Alan-JH/lemp11-nas/README.md

# lemp11-nas
Lemur Pro 11 to Low Power NAS Conversion
