Alan-JH/lemp11-nas/SATA_board/LM5175 Buck-Boost Quickstart Tool -- r9.xlsm

Sheet: Design Converter
LM5175 DC/DC Controller Design Tool
 |  |  |  |  |  |  |  |  |  |  | http://www.ti.com/product/lm5175
About |  | xx (http://www.ti.com/pol) |  |  | = Input Box |  |  |  |  |  | TERMS OF USE
Step 1: Operating Specifications
 |  |  | Input Voltage - Min, VIN(min) | 5 | V
 |  |  | Input Voltage - Nom, VIN(nom) | 19 | V
 |  |  | Input Voltage - Max, VIN(max) | 24 | V
 |  |  | Output Voltage, VOUT | 12 | V
 |  |  | Full Load Output Current, IOUT(max) | 6 | A
 |  |  | Switching Frequency | 224 | kHz
 |  |  | Frequency Set Resistor, RT | 115 | kΩ
Step 2: Filter Inductor
 |  |  | Recommended Filter Inductance | 4.2 | µH
 |  |  | Inductance, LF | 4.7 | µH
 |  |  | Inductor DCR | 6 | mΩ
 |  |  | Pk-to-Pk Ripple Current at VIN(min), DIL1 | 2.8 | Apk-pk
 |  |  | Pk-to-Pk Ripple Current at VIN(nom), DIL2 | 4.2 | Apk-pk
 |  |  | Pk-to-Pk Ripple Current at VIN(max), DIL3 | 5.7 | Apk-pk
 |  |  | DIL as a % at VIN(min) | 18.89568601 | %
 |  |  | DIL as a % at VIN(nom) | 70.30112057 | %
 |  |  | DIL as a % at VIN(max) | 95.45877849 | %
Step 3: OCP, Sense Resistors, Slope Comp
 |  |  | Required IOCP(MIN) Setpoint at VIN(nom) | 8 | A
 |  |  | Recommended Sense Resistance | 7.5 | mΩ
 |  |  | Sense Resistance, RS | 8 | mΩ
 |  |  | Peak Inductor Current, ILPK | 20.0 | A
 |  |  | Power Loss in Rs at Full Load (Min VIN) | 1.08 | W
 |  |  | Recommended SLOPE Capacitance | 150 | pF
 |  |  | SLOPE Capacitance, CSLOPE | 150 | pF
 |  |  | VIN(min) | 7.5 | A
 |  | IOUT(typ) at OCP Inception: | VIN(nom) | 12.1 | A
 |  |  | VIN(max) | 12.9 | A
 |  |  | Required Const Current Loop Setpoint | N/A | A
 |  |  | Output Leg Shunt Resistance, RCS(out) | 0 | mΩ
Step 4: Output Capacitor
 |  |  | Output Voltage Ripple Spec | 120 | mVpk-pk
 |  |  | Minimum Output Capacitance | 133.2 | µF
 |  |  | Output Capacitance, COUT | 272 | µF
 |  |  | Maximum Permitted ESR | 10.2 | mΩ
 |  |  | Output Capacitor ESR | 7 | mΩ
 |  |  | Resulting Output Voltage Ripple (max) | 100.771141 | mVpk-pk
 |  |  | Output Capacitor RMS Current (max) | 7.1 | A (rms)
 |  |  |  |  |  |  |  |  | VIN(nom) | 19V
Step 5: Input Capacitor
 |  |  | Input Voltage Ripple Spec | 100 | mVpk-pk
 |  |  | Minimum Input Capacitance | 67.0 | µF
 |  |  | Input Capacitance, CIN | 100 | µF
 |  |  | Maximum Permitted ESR | 3.7 | mΩ
 |  |  | Input Capacitor ESR | 2 | mΩ
 |  |  | Resulting Input Voltage Ripple (max) | 84.69181242 | mVpk-pk
 |  |  | Input Capacitor RMS Current (max) | 3.0 | A (rms)
Step 6: Soft-start, Dither, UVLO
 |  |  | Soft-Start Time, tSS | 15 | ms
 |  |  | Soft-Start Capacitance, CSS | 100 | nF
 |  |  | Modulating Frequency | 5 | kHz
 |  |  | DITH Capacitance, Cd | 8.2 | nF
 |  |  | Required Input Voltage UVLO On | 5.5 | V
 |  |  | Input Voltage UVLO Off | 4.84 | V
 |  |  | Upper UVLO Resistor, RUV1 | 200 | kΩ
 |  |  | Lower UVLO Resistor, RUV2 | 52.3 | kΩ
Step 7: Compensation Design
 |  |  | Load Pole Frequency | 781.5500886 | Hz
 |  |  | COUT ESR Zero Frequency | 83.58978113 | kHz
 |  |  | Boost RHP Zero Frequency | 9.052552037 | kHz
 |  |  | Desired Crossover Frequency | 10 | kHz
 |  |  | Error Amp Pole Frequency | 2.039626021 | Hz
 |  |  | Upper Feedback Resistor, RFB1 | 100 | kΩ
 |  |  | Lower Feedback Resistor, RFB2 | 7.15 | kΩ
Compensation Components
 | Calculated / | Std Values | Selected |  | Actual P/Z Frequencies
RC | 8.1 | 8.06 | 8.06 | kΩ | 2.039626021 | Hz (FPEA) | Min COMP Voltage | 1.07V
CC1 | 3.9 | 3.9 | 3.9 | nF | 5.1 | kHz (FZCOMP) | Max COMP Voltage | 2.58V
CC2 | 210.548727 | 220 | 220 | pF | 80.5096637 | kHz (FPCOMP)
Efficiency / Power Loss Analyzer
Step 8: Efficiency
 |  |  | Buck-Leg Power MOSFETs (Q1, Q2) | CSD18563Q5A
 |  |  |  | Hi-side | Low-side
 |  |  | On-State Resistance, RDS(on) | 3.4 | 5.3 | mΩ
 |  |  | Total Gate Charge, QG | 27 | 16 | nC
 |  |  | Gate-Drain Charge, QGD | 4.3 | 2.4 | nC
 |  |  | Gate-Source Charge, QGS | 4.5 | 3.2 | nC
 |  |  | Gate Resistance, RG | 1.2 | 1.4 | Ω
 |  |  | Transconductance, gFS | 100 | 71 | S
 |  |  | Gate-Source Threshold Voltage, VTH | 1.8 | 1.9 | V
 |  |  | Body Diode Forward Voltage, VBD | 0.8 | 0.8 | V
 |  |  | Body Diode Rev Recovery Charge, QRR |  | 39 | nC
 |  |  | Thermal Resistance, θJA | 50 | 50 | °C/W
 |  |  | Boost-Leg Power MOSFETs (Q3, Q4) | CSD16321Q5
 |  |  |  | Hi-side | Low-side
 |  |  | On-State Resistance, RDS(on) | 1.9 | 1.9 | mΩ
 |  |  | Total Gate Charge, QG | 22 | 22 | nC
 |  |  | Gate-Drain Charge, QGD | 2.5 | 2.5 | nC
 |  |  | Gate-Source Charge, QGS | 4 | 4 | nC
 |  |  | Gate Resistance, RG | 1.5 | 1.5 | Ω
 |  |  | Transconductance, gFS | 150 | 150 | S
 |  |  | Gate-Source Threshold Voltage, VTH | 2 | 2 | V
 |  |  | Body Diode Forward Voltage, VBD | 0.8 | 0.8 | V
 |  |  | Body Diode Rev Recovery Charge, QRR | 33 |  | nC
 |  |  | Thermal Resistance, θJA | 50 | 50 | °C/W
External Schottky Diode (if applicable) |  |  |  | Buck Leg | Boost Leg
 |  |  | Schottky Fwd Voltage, VFWDsch | 0 | 0 | V
 |  |  | Schottky Rev Recovery Charge, QRRsch | 0 | 0 | nC

Sheet: BOM & Schematic
 | ** Tie MODE to VCC (or voltage > 2.4V) for CCM, GND for DCM **
VIN = 5 V to 24 V, VOUT = 12 V, IOUT = 6 A, Fsw = 224 kHz, Current Limit = 8 A
High Efficiency Synchronous Buck-Boost Regulator BOM
Count | Ref Des | Value | Description |  | Size | Part Number | MFR
2 | CBOOT1, CBOOT2 | 0.1µF | Capacitor, Ceramic,0.1-µF, 50V, X7R, 20% |  | 0603 | Std | Std
1 | CC1 | 3.9nF | Capacitor, Ceramic,3.9-nF, 16V, X7R, 10% |  | 0603 | Std | Std
1 | CC2 | 220pF | Capacitor, Ceramic,220-pF, 50V, NP0, 5% |  | 0603 | Std | Std
1 | CSLOPE | 150pF | Capacitor, Ceramic,150-pF, 50V, NP0, 5% |  | 0603 | Std | Std
1 | CCS | 100pF | Capacitor, Ceramic,100-pF, 16V, X7R, 10% |  | 0603 | Std | Std
1 | CDITH | 8.2nF | Capacitor, Ceramic,8.2-nF, 16V, X7R, 10% |  | 0603 | Std | Std
10 | CIN | 10µF | Capacitor, Ceramic,10-µF, 50V, X7R, 20% |  | 1210 | Std | Std
13 | COUT | 22µF | Capacitor, Ceramic,22-µF, 25V, X5R, 20% |  | 1210 | Std | Std
1 | CSS | 100nF | Capacitor, Ceramic,100-nF, 16V, X7R, 10% |  | 0603 | Std | Std
1 | CVCC | 1µF | Capacitor, Ceramic,1-µF, 25V, X7R, 20% |  | 0603 | Std | Std
1 | CVIN | 0.1µF | Capacitor, Ceramic,0.1-µF, 100V, X7R, 20% |  | 0603 | Std | Std
3 | DBOOT1, DBOOT2, DVIN | See description | Schottky Diode, 200mA |  | - | - | Various
1 | LF | 4.7µH | Inductor, 4.7µH, 6mΩ, >22A |  | - | - | Various
2 | Q1, Q2 | See description | MOSFET, N-CH, 60V,3.4mΩ |  | Std | CSD18563Q5A | -
2 | Q3, Q4 | See description | MOSFET, N-CH, 60V,1.9mΩ |  | Std | CSD16321Q5 | -
1 | RC1 | 8.06k | Resistor, Chip,8.06-kΩ, 1/16W, 1% |  | 0603 | Std | Std
1 | RS | 8m | Resistor, Chip,8-mΩ, 2W, 1% |  | 2512 | Std | Std
1 | RCS(out) | 0m | Resistor, Chip,0-mΩ, 2W, 1% |  | 2512 | Std | Std
1 | RT | 115k | Resistor, Chip,115-kΩ, 1/16W, 1% |  | 0603 | Std | Std
1 | RFB1 | 100k | Resistor, Chip,100-kΩ, 1/16W, 1% |  | 0603 | Std | Std
1 | RFB2 | 7.15k | Resistor, Chip,7.15-kΩ, 1/16W, 1% |  | 0603 | Std | Std
1 | RPGOOD | 20k | Resistor, Chip,20-kΩ, 1/16W, 1% |  | 0603 | Std | Std
2 | RCS, RCSG | 100 | Resistor, Chip,100-Ω, 1/16W, 1% |  | 0603 | Std | Std
1 | RUV1 | 200k | Resistor, Chip,200-kΩ, 1/16W, 1% |  | 0603 | Std | Std
1 | RUV2 | 52.3k | Resistor, Chip,52.3-kΩ, 1/16W, 1% |  | 0603 | Std | Std
1 | RVIN | 2.2 | Resistor, Chip,2.2-Ω, 1/16W, 1% |  | 0603 | Std | Std
1 | U1 | LM5175 | IC, LM5175, Buck-Boost PWM Controller, 3.5V–42V Input |  | QFN-28 | LM5175RHF | TI
 |  |  |  |  | TSSOP-28 | LM5175PWP
NOTES:
** For information on TI NexFETTM MOSFETs, see ** |  |  | http://www.ti.com/nexfet | **
** Inductor saturation current should be higher than the peak inductor current at the OCP setpoint for all input voltages and operating temperatures **
** Effective input and output capacitances should be appropriately derated for applied voltage and temperature, particularly with ceramics **

Sheet: EVMs
LM5175 Quickstart Design Tool
 | LM5175EVM-HD PCB Layout | LM5175EVM-HP PCB Layout | LM5175EVM PCB Layout
