Alan-JH/lemp11-nas/case/lemp11-mainboard-test-left.STL

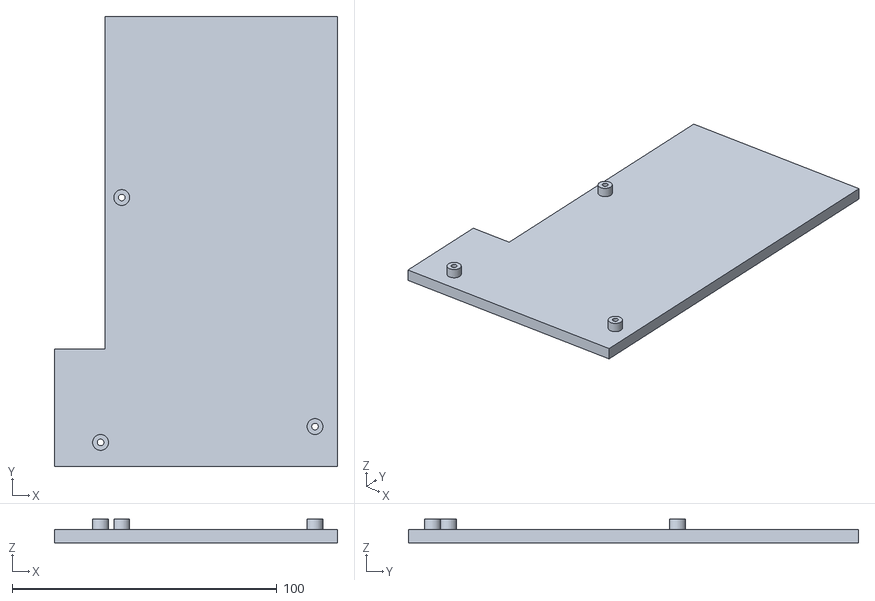
[picture p1: CAD file, 2026-09-23]
case/lemp11-mainboard-test-left.STL
106.9 x 170.0 x 9.00
