Alan-JH/lemp11-nas/case/lemp11-mainboard-test.SLDPRT

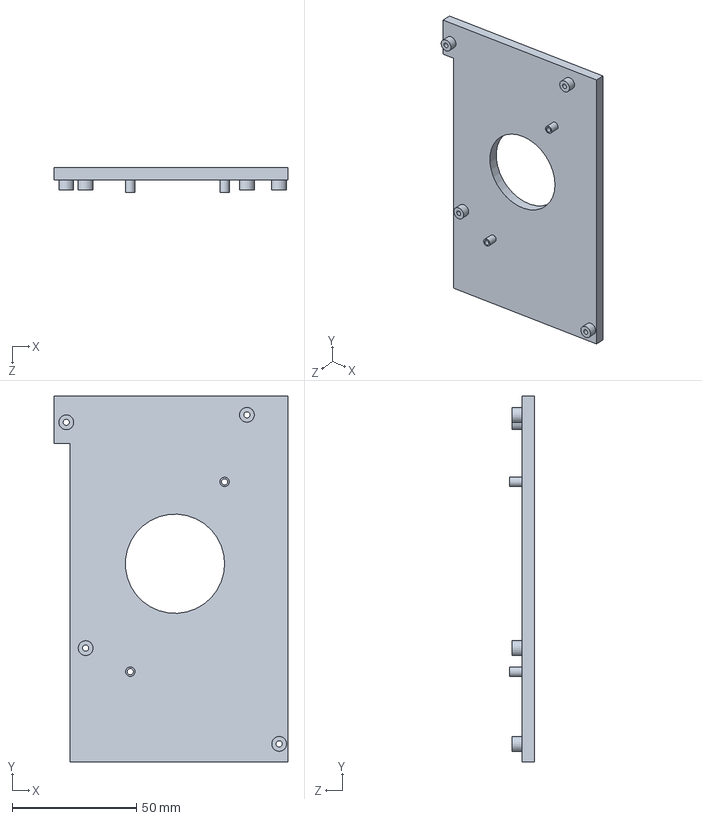
[picture p2: CAD file, 2026-09-23]
case/lemp11-mainboard-test.SLDPRT
94.2 x 147.5 x 10.0 mm
