Alan-JH/lemp11-nas/case/topcase.STEP

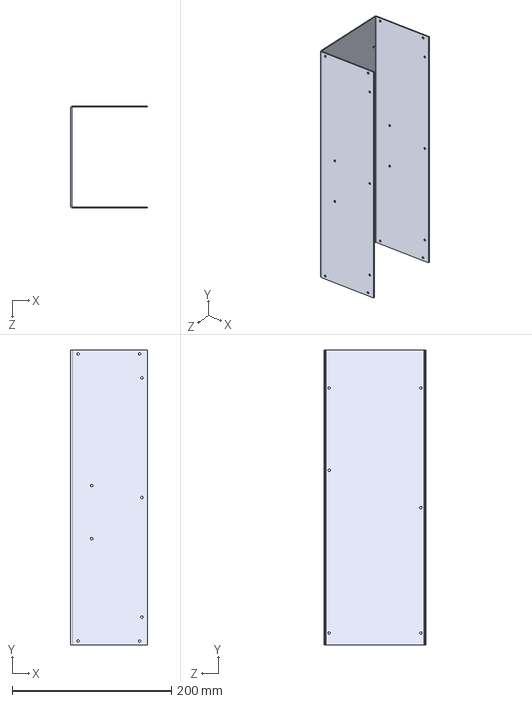
[picture p3: CAD file, 2026-10-31]
case/topcase.STEP
96.6 x 370.0 x 128.2 mm
