Alan-JH/lemp11-nas/SATA_board/CFP15_SOT1289_NEX.step

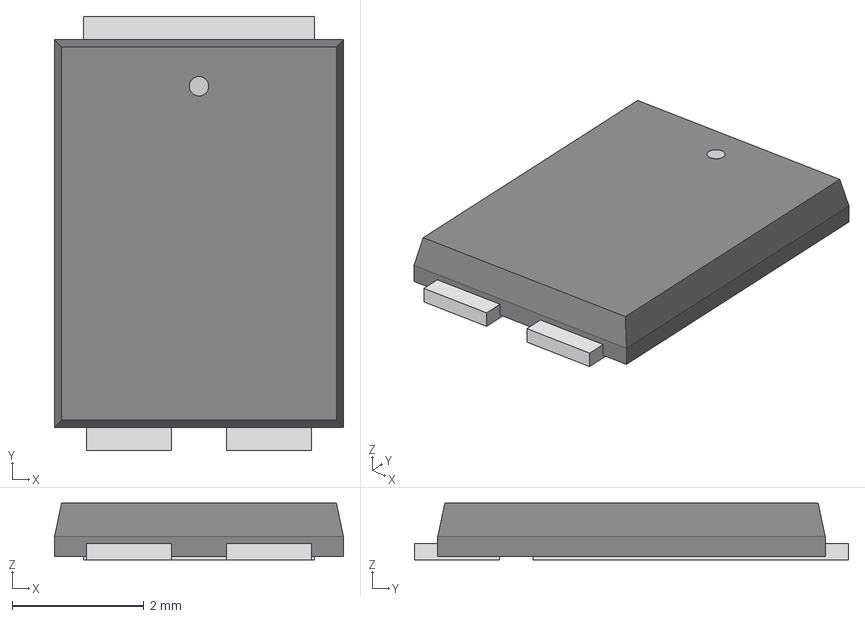
[picture p4: CAD file, 2026-10-28]
SATA_board/CFP15_SOT1289_NEX.step
4.39 x 6.60 x 0.866 mm
