Alan-JH/lemp11-nas/case/lemp11-mountingplate.STEP

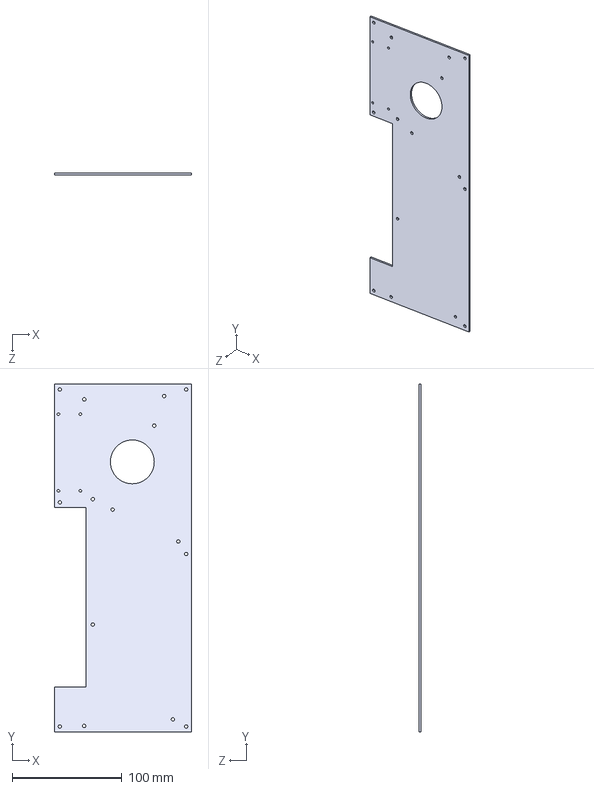
[picture p5: CAD file, 2026-10-31]
case/lemp11-mountingplate.STEP
125.0 x 317.3 x 2.00 mm
