Alan-JH/lemp11-nas/case/Boardmount.STEP

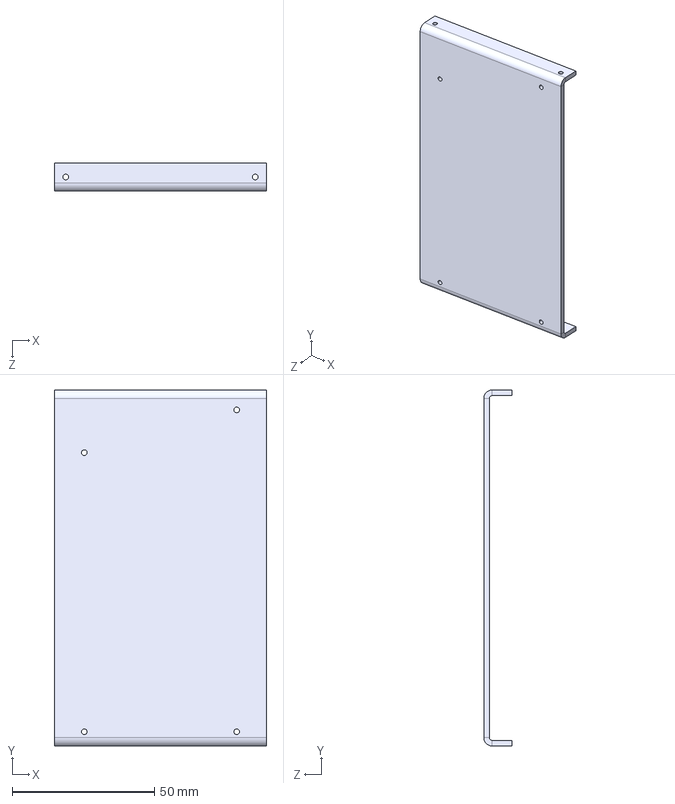
[picture p6: CAD file, 2026-10-31]
case/Boardmount.STEP
74.5 x 125.0 x 10.0 mm
