Alan-JH/lemp11-nas/case/bottomcase.STEP

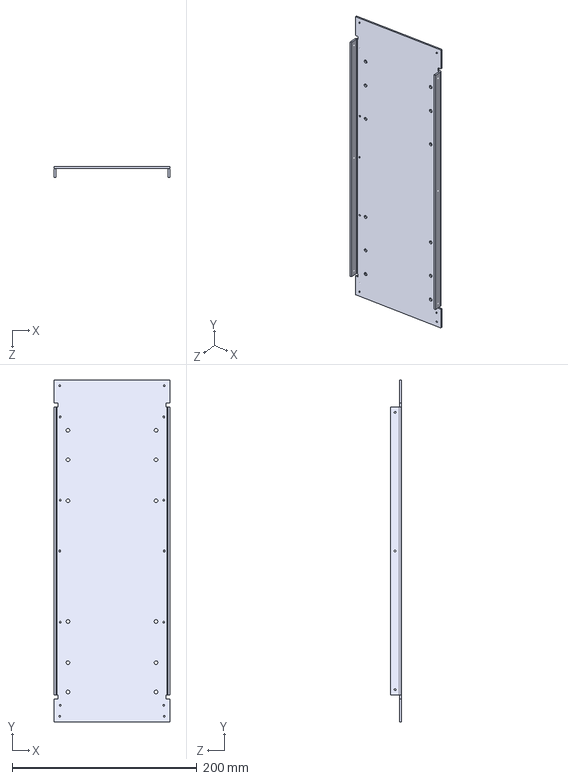
[picture p7: CAD file, 2026-10-31]
case/bottomcase.STEP
125.0 x 370.0 x 12.0 mm
