Alan-JH/lemp11-nas/case/heatsink.SLDPRT

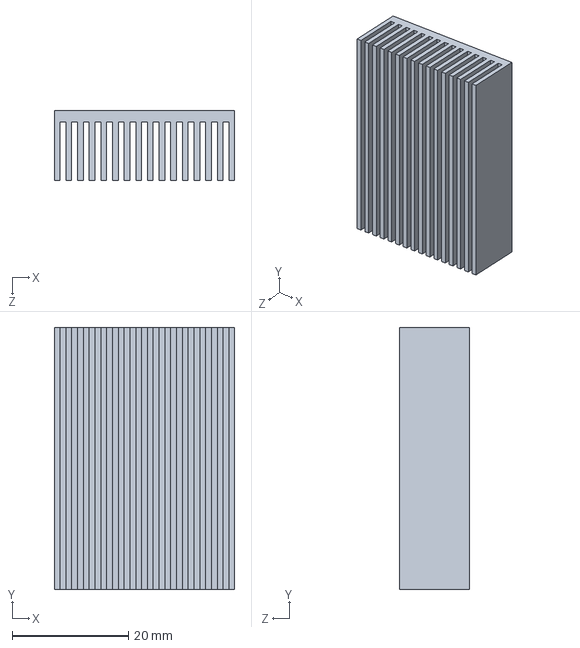
[picture p8: CAD file, 2026-10-28]
case/heatsink.SLDPRT
31.0 x 45.0 x 12.0 mm
