Alan-JH/lemp11-nas/case/SATA_board.step

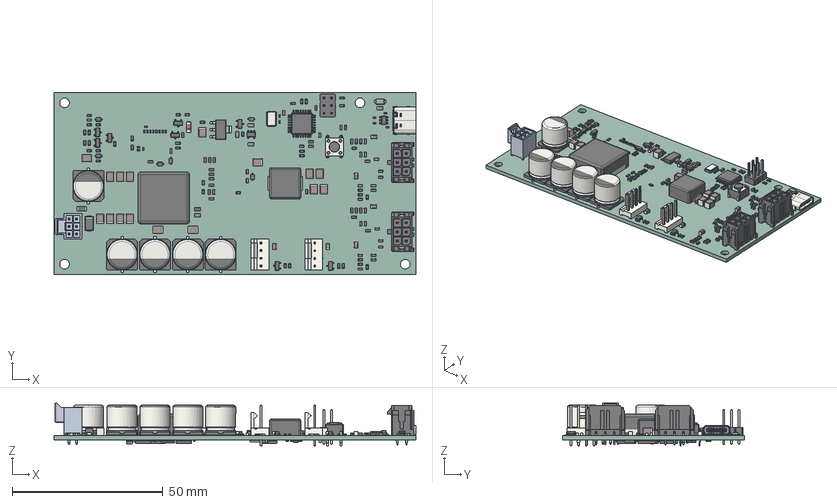
[picture p9: CAD file, 2026-10-28]
case/SATA_board.step
120.1 x 60.5 x 14.2 mm
C_0603_1608Metric x 43
C_1210_3225Metric x 16
C_0402_1005Metric x 8
R_0402_1005Metric x 14
D_SMA
R_0603_1608Metric x 58
D_SOD-323F x 9
FanPinHeader_1x04_P2.54mm_Vertical x 2
CP_Elec_10x10 x 5
SOT-23 x 8
C_0805_2012Metric x 12
SOT-23-6
PinHeader_2x03_P2.54mm_Vertical
SW_PUSH_6mm
L_Vishay_IHLP-4040
Fuse_1206_3216Metric
SOT-23-5
USB_C_Receptacle_GCT_USB4105-xx-A_16P_TopMnt_Horizontal
D_MiniMELF
Crystal_SMD_Abracon_ABM3B-4Pin_5.0x3.2mm
D_SMF
L_Vishay_IHLP-6767
LQFP-32_7x7mm_P0.8mm
R_0805_2012Metric x 2
SOT-223
TDSON-8-1 x 6
R_2512_6332Metric x 2
CFP15_SOT1289_NEX x 2
SATA_board_PCB
