Alan-JH/lemp11-nas/case/ssdplate.SLDPRT

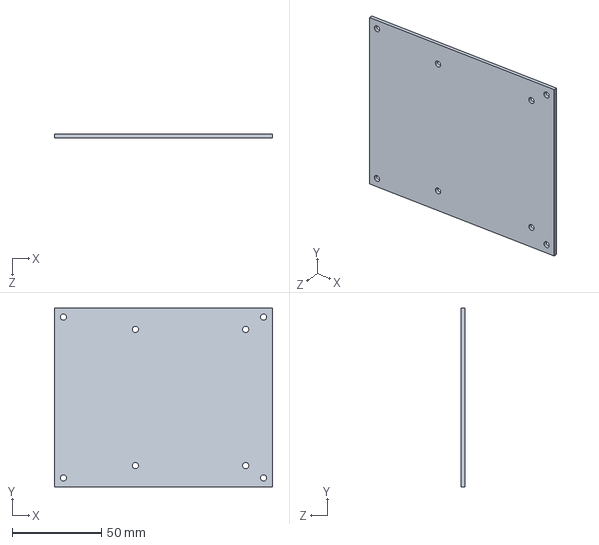
[picture p10: CAD file, 2026-10-28]
case/ssdplate.SLDPRT
122.0 x 100.0 x 2.00 mm
