Alan-JH/lemp11-nas/case/iocover.SLDPRT

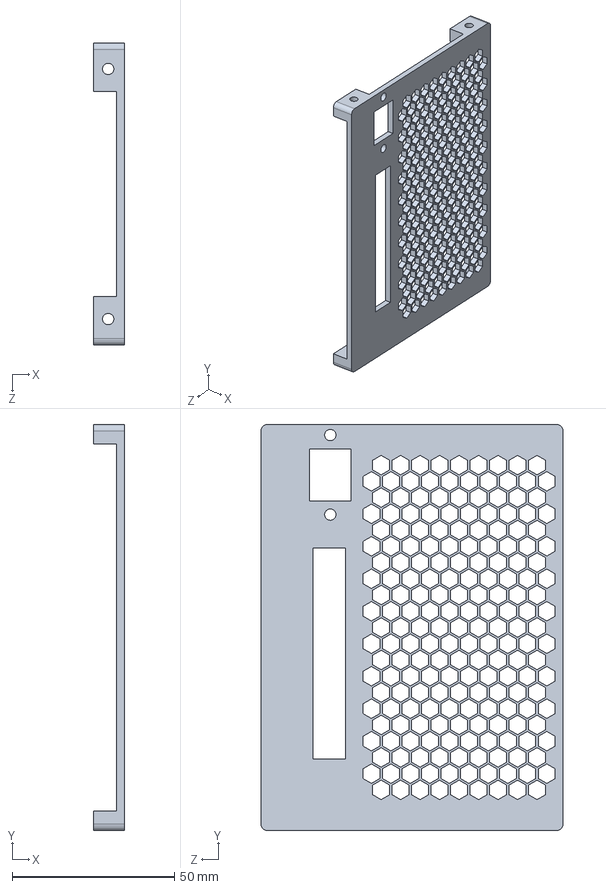
[picture p11: CAD file, 2026-10-28]
case/iocover.SLDPRT
9.50 x 125.0 x 93.0 mm
