Alan-JH/lemp11-nas/case/SSD_SATA_2.5.step

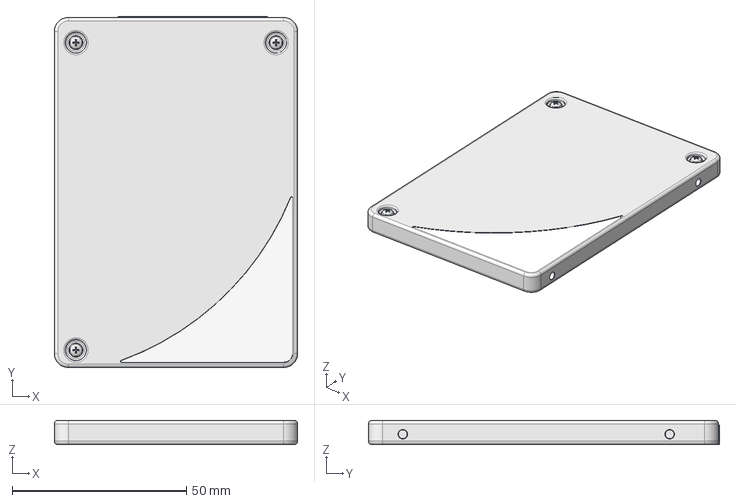
[picture p12: CAD file, 2026-10-27]
case/SSD_SATA_2.5.step
69.8 x 100.8 x 7.00 mm
