Alan-JH/lemp11-nas/case/feet.SLDPRT

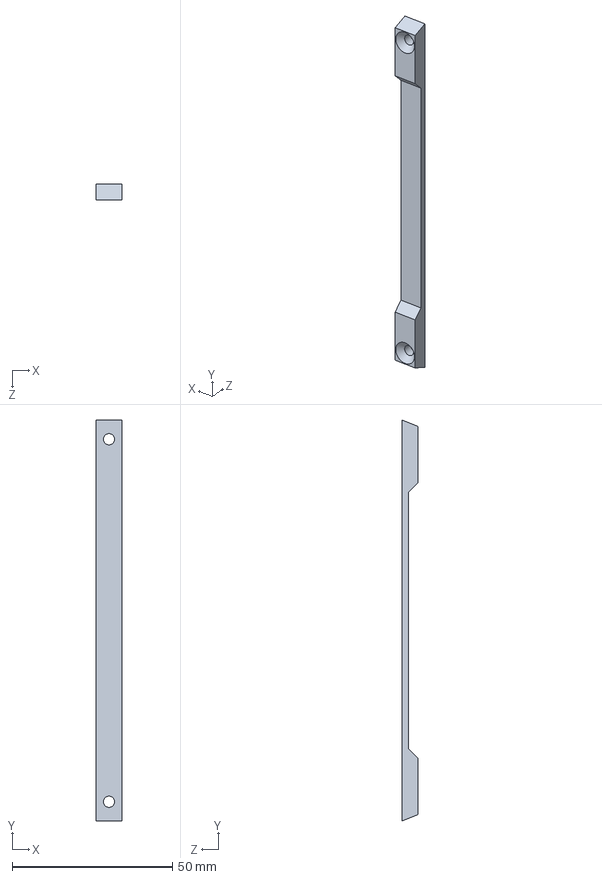
[picture p13: CAD file, 2026-10-27]
case/feet.SLDPRT
8.00 x 125.0 x 5.00 mm
