Alan-JH/lemp11-nas/case/F9.STEP

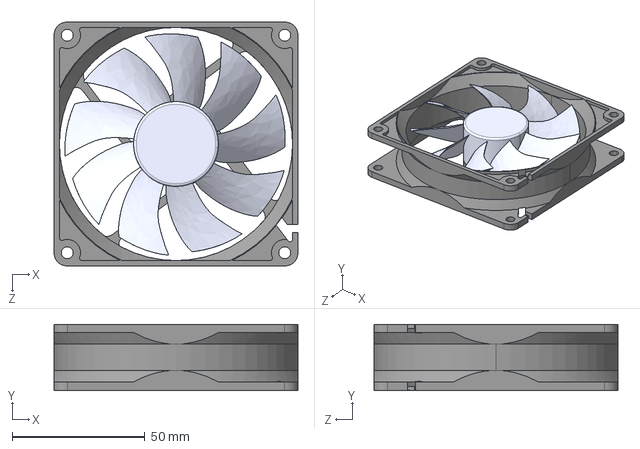
[picture p14: CAD file, 2026-10-27]
case/F9.STEP
92.0 x 25.0 x 92.0 mm
F9 body
F9 fan
