Alan-JH/lemp11-nas/case/fanmount.SLDPRT

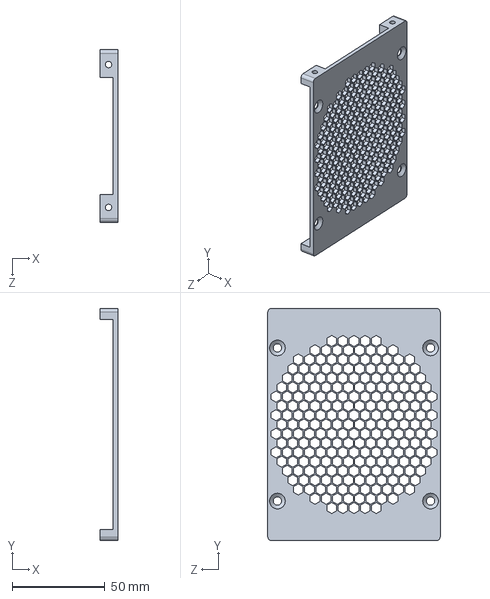
[picture p15: CAD file, 2026-10-27]
case/fanmount.SLDPRT
9.50 x 125.0 x 93.0 mm
