Alan-JH/lemp11-nas/case/lemp11-battery-lowerplate.SLDPRT

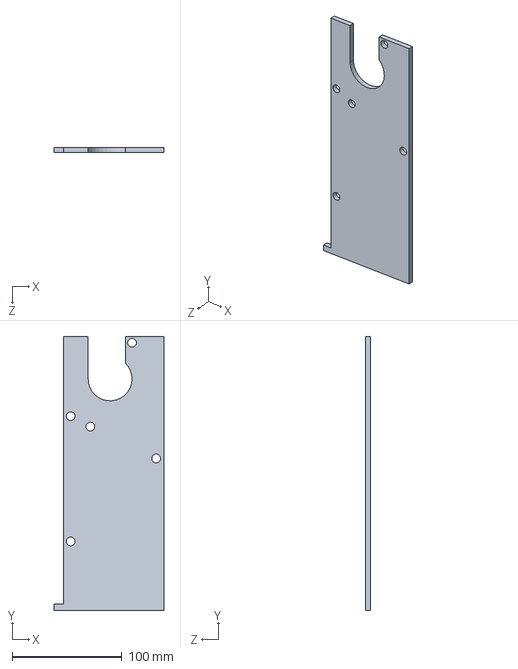
[picture p16: CAD file, 2026-10-16]
case/lemp11-battery-lowerplate.SLDPRT
100.0 x 250.0 x 5.00 mm
