Alan-JH/lemp11-nas/case/Assembly.SLDASM

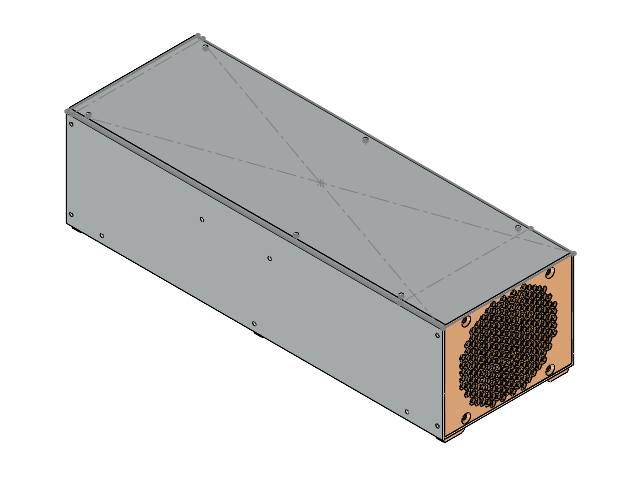
[picture p17: CAD file, 2026-10-31]
case/Assembly.SLDASM
bottomcase
topcase
lemp11-mountingplate
feet x 3
fanmount
F9 body.STEP
F9 fan.STEP
EL90126--STD--HDD SATA 3.5 x 2
iocover
ssdplate x 2
93655A229_Male-Female Threaded Hex Standoff x 8
Body.step x 2
Body002.step x 2
ANSI B18.6.7M - M2x0,4 x 2,5.step x 6
SOLID.step
COMPOUND.step
C_0603_1608Metric.step x 43
C_1210_3225Metric.step x 16
C_0402_1005Metric.step x 8
R_0402_1005Metric.step x 14
D_SMA.step
R_0603_1608Metric.step x 58
D_SOD-323F.step x 9
FanPinHeader_1x04_P2.54mm_Vertical.step x 2
CP_Elec_10x10.step x 5
SOT-23.step x 8
C_0805_2012Metric.step x 12
SOT-23-6.step
PinHeader_2x03_P2.54mm_Vertical.step
SW_PUSH_6mm.step
L_Vishay_IHLP-4040.step
Fuse_1206_3216Metric.step
SOT-23-5.step
USB_C_Receptacle_GCT_USB4105-xx-A_16P_TopMnt_Horizontal.step
D_MiniMELF.step
Crystal_SMD_Abracon_ABM3B-4Pin_5.0x3.2mm.step
430450612.step x 2
D_SMF.step
L_Vishay_IHLP-6767.step
LQFP-32_7x7mm_P0.8mm.step
R_0805_2012Metric.step x 2
SOT-223.step
TDSON-8-1.step x 6
R_2512_6332Metric.step x 2
CFP15_SOT1289_NEX.step x 2
SATA_board_PCB.step
92080A415_Zinc-Plated Brass Female Threaded Hex Standoff x 6
Boardmount
