Alan-JH/lemp11-nas/(list of files, cad)

Other CAD files:
case/lemp11-mainboard-test-right.STL
SATA_board/1053101206.stp
SATA_board/430450612.stp
case/92080A415_Zinc-Plated Brass Female Threaded Hex Standoff.SLDPRT
case/93655A100_Male-Female Threaded Hex Standoff.SLDPRT
case/93655A229_Male-Female Threaded Hex Standoff.SLDPRT
case/94868A012_Female Threaded Hex Standoff.SLDPRT
case/Boardmount.SLDPRT
case/EL90126--STD--HDD SATA 3.5.SLDPRT
case/EL90126--STD--HDD SATA 3.5.STEP
case/F9.SLDASM
case/SATA_board.SLDASM
case/SSD_SATA_2.5.SLDASM
case/bottomcase.SLDPRT
case/fanmount.STL
case/lemp11-mountingplate.DXF
case/lemp11-mountingplate.SLDPRT
case/topcase.SLDPRT
