Alan-JH/lemp11-nas/SATA_board/SATA_board.kicad_pcb

## KiCad design SATA_board/SATA_board.kicad_pcb (2026-10-28)

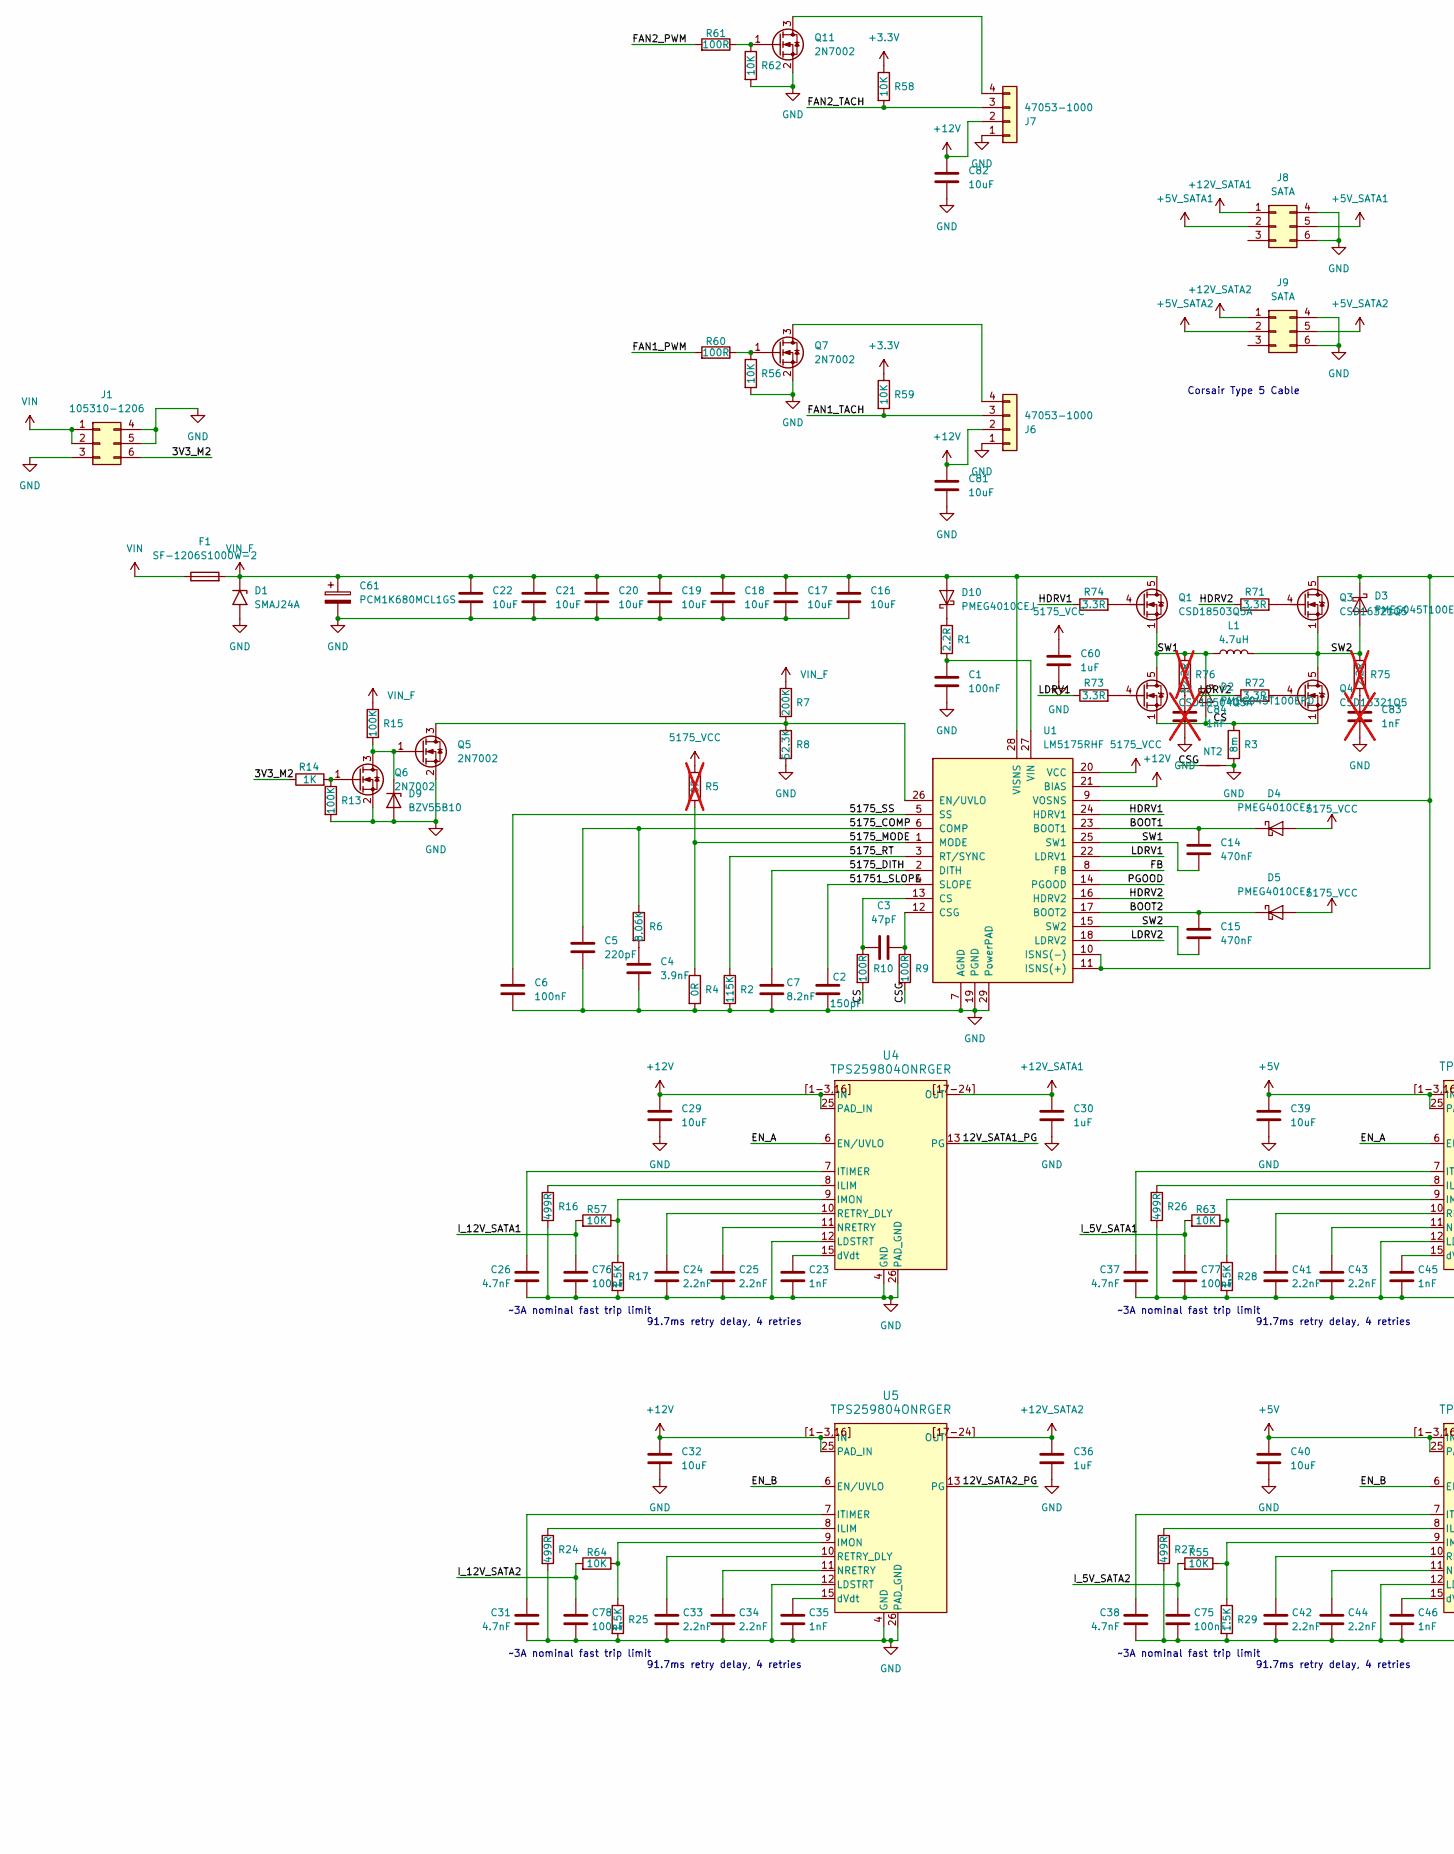
[picture p18: schematic SATA_board.kicad_sch, part in row 1, column 1]

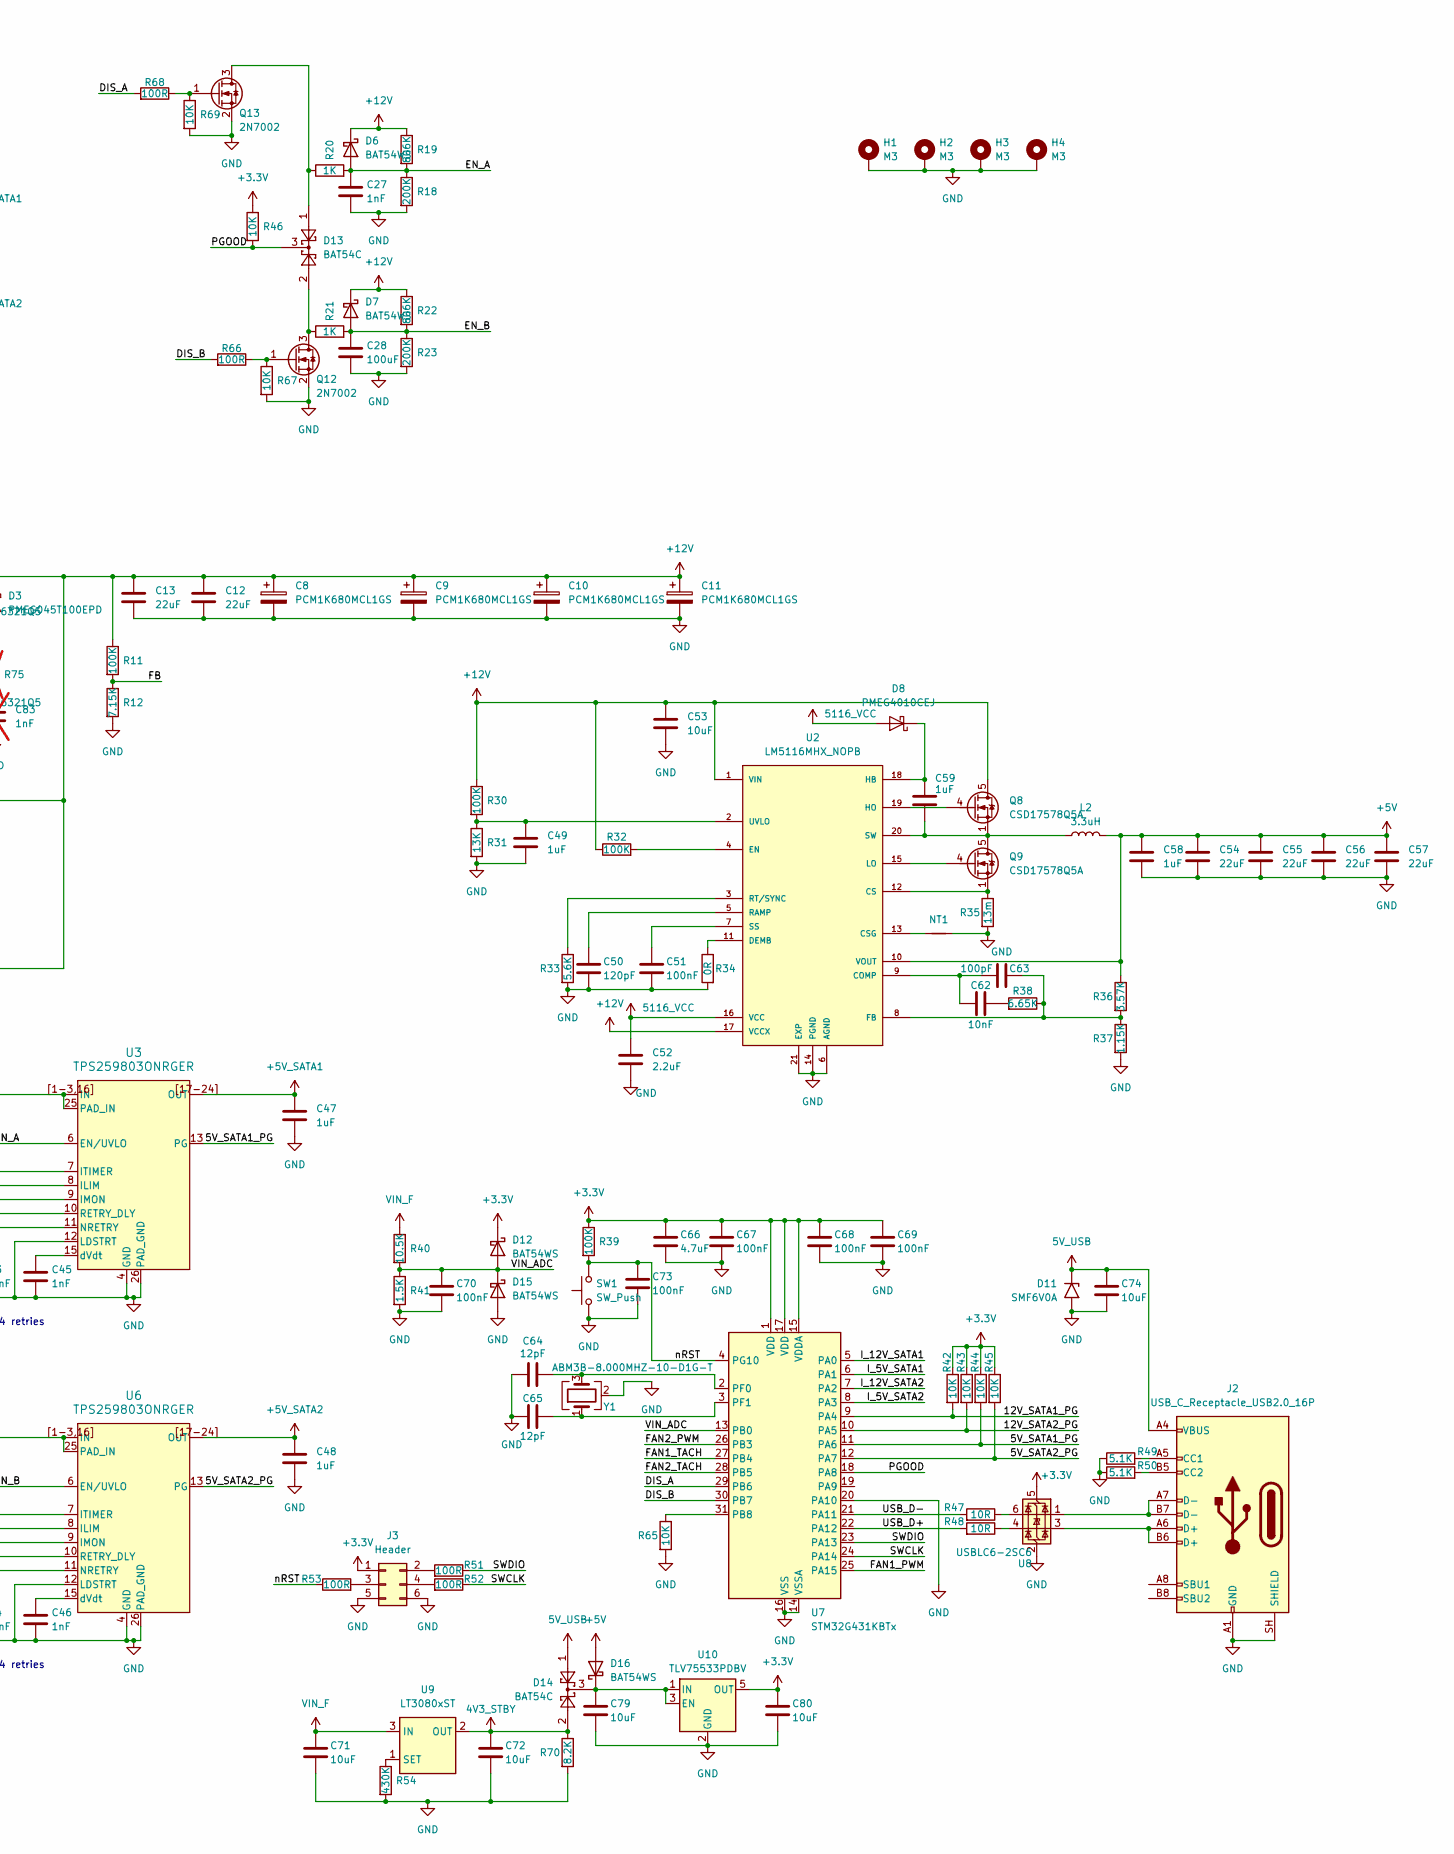
[picture p19: schematic SATA_board.kicad_sch, part in row 1, column 2]

Parts:
C1, C51, C67, C68, C69, C70, C73, C75, C76, C77, C78: 100nF; C_0603_1608Metric
C2: 150pF; C_0402_1005Metric
C3: 47pF; C_0402_1005Metric
C4: 3.9nF; C_0402_1005Metric
C5: 220pF; C_0402_1005Metric
C6: 100nF; C_0402_1005Metric
C7: 8.2nF; C_0402_1005Metric
C8, C9, C10, C11, C61: PCM1K680MCL1GS; CP_Elec_10x10
C12, C13, C54, C55, C56, C57: 22uF; C_1210_3225Metric
C14, C15: 470nF; C_0603_1608Metric
C16, C17, C18, C19, C20, C21, C22, C53, C71: 10uF; C_1210_3225Metric
C23, C27, C35, C45, C46: 1nF; C_0603_1608Metric
C24, C25, C33, C34, C41, C42, C43, C44: 2.2nF; C_0603_1608Metric
C26, C31, C37, C38: 4.7nF; C_0603_1608Metric
C28: 100uF; C_1210_3225Metric
C29, C32, C39, C40, C72, C74, C79, C80, C81, C82: 10uF; C_0805_2012Metric
C30, C36, C47, C48, C49, C58, C59, C60: 1uF; C_0603_1608Metric
C50: 120pF; C_0603_1608Metric
C52: 2.2uF; C_0603_1608Metric
C62: 10nF; C_0603_1608Metric
C63: 100pF; C_0603_1608Metric
C64, C65: 12pF; C_0402_1005Metric
C66: 4.7uF; C_0603_1608Metric
C83, C84: 1nF; C_0805_2012Metric; not fitted
D1: SMAJ24A; D_SMA
D2, D3: PMEG045T100EPD; Nexperia_CFP15_SOT-1289
D4, D5, D8, D10: PMEG4010CEJ; D_SOD-323F
D6, D7, D12, D15, D16: BAT54WS; D_SOD-323F
D9: BZV55B10; D_MiniMELF
D11: SMF6V0A; D_SMF
D13, D14: BAT54C; SOT-23
F1: SF-1206S1000W-2; Fuse_1206_3216Metric
H1, H2, H3, H4: M3; MountingHole_3.2mm_M3_DIN965_Pad
J1: 105310-1206; Molex_Nano-Fit_105310-xx06_2x03_P2.50mm_Vertical
J2: USB_C_Receptacle_USB2.0_16P; USB_C_Receptacle_GCT_USB4105-xx-A_16P_TopMnt_Horizontal
J3: Header; PinHeader_2x03_P2.54mm_Vertical
J6, J7: 47053-1000; FanPinHeader_1x04_P2.54mm_Vertical
J8, J9: SATA; Molex_Micro-Fit_3.0_43045-0612_2x03_P3.00mm_Vertical
L1: 4.7uH; L_Vishay_IHLP-6767
L2: 3.3uH; L_Vishay_IHLP-4040
NT1, NT2: NetTie-2_SMD_Pad0.5mm
Q1: CSD18503Q5A; TDSON-8-1
Q2: CSD18504Q5A; TDSON-8-1
Q3, Q4: CSD16321Q5; TDSON-8-1
Q5, Q6, Q7, Q11, Q12, Q13: 2N7002; SOT-23
Q8, Q9: CSD17578Q5A; TDSON-8-1
R1: 2.2R; R_0603_1608Metric
R2: 115K; R_0402_1005Metric
R3: 8m; R_2512_6332Metric
R4: 0R; R_0402_1005Metric
R5: 0R; R_0402_1005Metric; not fitted
R6: 8.06K; R_0402_1005Metric
R7, R18, R23: 200K; R_0603_1608Metric
R8: 52.3K; R_0603_1608Metric
R9, R10: 100R; R_0402_1005Metric
R11, R13, R15, R30, R32, R39: 100K; R_0603_1608Metric
R12: 7.15K; R_0603_1608Metric
R14, R20, R21: 1K; R_0603_1608Metric
R16, R24, R26, R27: 499R; R_0603_1608Metric
R17, R25, R28, R29, R41: 1.5K; R_0603_1608Metric
R19, R22: 806K; R_0603_1608Metric
R31: 13K; R_0603_1608Metric
R33: 5.6K; R_0603_1608Metric
R34: 0R; R_0603_1608Metric
R35: 13m; R_2512_6332Metric
R36: 3.57K; R_0603_1608Metric
R37: 1.15K; R_0603_1608Metric
R38: 6.65K; R_0603_1608Metric
R40: 10.5K; R_0603_1608Metric
R42, R43, R44, R45, R46, R55, R56, R57, R58, R59, R62, R63, R64, R65, R67, R69: 10K; R_0603_1608Metric
R47, R48: 10R; R_0402_1005Metric
R49, R50: 5.1K; R_0402_1005Metric
R51, R52, R53, R60, R61, R66, R68: 100R; R_0603_1608Metric
R54: 430K; R_0603_1608Metric
R70: 8.2K; R_0603_1608Metric
R71, R72, R73, R74: 3.3R; R_0402_1005Metric
R75, R76: 2.2R; R_0805_2012Metric; not fitted
SW1: SW_Push; SW_PUSH_6mm
U1: LM5175RHF; VQFN-28-1EP_4x5mm_P0.5mm_EP2.55x3.55mm
U2: LM5116MHX_NOPB; SOP65P640X110-21N; PARTREV H
U3, U6: TPS259803ONRGER; IC24_TPS259802ONRGER_TEX
U4, U5: TPS259804ONRGER; IC24_TPS259802ONRGER_TEX
U7: STM32G431KBTx; LQFP-32_7x7mm_P0.8mm
U8: USBLC6-2SC6; SOT-23-6
U9: LT3080xST; SOT-223
U10: TLV75533PDBV; SOT-23-5
Y1: ABM3B-8.000MHZ-10-D1G-T; Crystal_SMD_Abracon_ABM3B-4Pin_5.0x3.2mm

Connections:
4V3_STBY: C72.1, D14.2, R70.1, U9.2 (OUT), U9.4 (OUT)
5V_USB: C74.1, D11.1 (A1), D14.1, J2.A4 (VBUS), J2.A9 (VBUS), J2.B4 (VBUS), J2.B9 (VBUS)
5116_VCC: C52.1, D8.2 (A), U2.16 (VCC)
5175_VCC: C60.1, D4.2 (A), D5.2 (A), R5.1, U1.20 (VCC)
+3.3V: C66.1, C67.1, C68.1, C69.1, C80.1, D12.1 (K), J3.1, R39.1, R42.1, R43.1, R44.1, R45.1, R46.1, R58.1, R59.1, U7.1 (VDD), U7.15 (VDDA), U7.17 (VDD), U8.5 (VBUS), U10.5 (OUT)
+5V: C39.1, C40.1, C54.1, C55.1, C56.1, C57.1, C58.1, D16.2 (A), L2.2, R36.1, U2.10 (VOUT), U3.1 (IN), U3.2 (IN), U3.3 (IN), U3.16 (IN), U3.25 (PAD_IN), U3.[1-3,16] (IN), U6.1 (IN), U6.2 (IN), U6.3 (IN), U6.16 (IN), U6.25 (PAD_IN), U6.[1-3,16] (IN)
+5V_SATA1: C47.1, J8.2, J8.5, U3.17 (OUT), U3.18 (OUT), U3.19 (OUT), U3.20 (OUT), U3.21 (OUT), U3.22 (OUT), U3.23 (OUT), U3.24 (OUT), U3.[17-24] (OUT)
+5V_SATA2: C48.1, J9.2, J9.5, U6.17 (OUT), U6.18 (OUT), U6.19 (OUT), U6.20 (OUT), U6.21 (OUT), U6.22 (OUT), U6.23 (OUT), U6.24 (OUT), U6.[17-24] (OUT)
+12V: C8.1, C9.1, C10.1, C11.1, C12.1, C13.1, C29.1, C32.1, C53.1, C81.1, C82.1, D3.3 (K), D6.1 (K), D7.1 (K), J6.2, J7.2, Q3.5 (D), Q8.5 (D), R11.1, R19.1, R22.1, R30.1, R32.1, U1.9 (VOSNS), U1.10 (ISNS(-)), U1.11 (ISNS(+)), U1.21 (BIAS), U2.1 (VIN), U2.17 (VCCX), U4.1 (IN), U4.2 (IN), U4.3 (IN), U4.16 (IN), U4.25 (PAD_IN), U4.[1-3,16] (IN), U5.1 (IN), U5.2 (IN), U5.3 (IN), U5.16 (IN), U5.25 (PAD_IN), U5.[1-3,16] (IN)
+12V_SATA1: C30.1, J8.1, U4.17 (OUT), U4.18 (OUT), U4.19 (OUT), U4.20 (OUT), U4.21 (OUT), U4.22 (OUT), U4.23 (OUT), U4.24 (OUT), U4.[17-24] (OUT)
+12V_SATA2: C36.1, J9.1, U5.17 (OUT), U5.18 (OUT), U5.19 (OUT), U5.20 (OUT), U5.21 (OUT), U5.22 (OUT), U5.23 (OUT), U5.24 (OUT), U5.[17-24] (OUT)
/3V3_M2: J1.6, R14.1
/5V_SATA1_PG: R44.2, U3.13 (PG), U7.11 (PA6)
/5V_SATA2_PG: R45.2, U6.13 (PG), U7.12 (PA7)
/12V_SATA1_PG: R42.2, U4.13 (PG), U7.9 (PA4)
/12V_SATA2_PG: R43.2, U5.13 (PG), U7.10 (PA5)
/5175_COMP: C5.1, R6.1, U1.6 (COMP)
/5175_DITH: C7.1, U1.2 (DITH)
/5175_MODE: R4.1, R5.2, U1.1 (MODE)
/5175_RT: R2.1, U1.3 (RT/SYNC)
/5175_SS: C6.1, U1.5 (SS)
/51751_SLOPE: C2.1, U1.4 (SLOPE)
/BOOT1: C14.1, D4.1 (K), U1.23 (BOOT1)
/BOOT2: C15.1, D5.1 (K), U1.17 (BOOT2)
/CS: D2.1 (A), D2.2 (A), Q2.1 (S), Q2.2 (S), Q2.3 (S), Q4.1 (S), Q4.2 (S), Q4.3 (S), R3.1, R10.2
/CSG: NT2.1, R9.2
/DIS_A: R68.2, U7.29 (PB6)
/DIS_B: R66.2, U7.30 (PB7)
/EN_A: C27.1, D6.2 (A), R18.1, R19.2, R20.2, U3.6 (EN/UVLO), U4.6 (EN/UVLO)
/EN_B: C28.1, D7.2 (A), R21.2, R22.2, R23.1, U5.6 (EN/UVLO), U6.6 (EN/UVLO)
/FAN1_PWM: R60.2, U7.25 (PA15)
/FAN1_TACH: J6.3, R59.2, U7.27 (PB4)
/FAN2_PWM: R61.2, U7.26 (PB3)
/FAN2_TACH: J7.3, R58.2, U7.28 (PB5)
/FB: R11.2, R12.1, U1.8 (FB)
/HDRV1: R74.1, U1.24 (HDRV1)
/HDRV2: R71.1, U1.16 (HDRV2)
/I_5V_SATA1: C77.1, R63.2, U7.6 (PA1)
/I_5V_SATA2: C75.1, R55.2, U7.8 (PA3)
/I_12V_SATA1: C76.1, R57.2, U7.5 (PA0)
/I_12V_SATA2: C78.1, R64.2, U7.7 (PA2)
/LDRV1: R73.1, U1.22 (LDRV1)
/LDRV2: R72.1, U1.18 (LDRV2)
/PGOOD: D13.3, R46.2, U1.14 (PGOOD), U7.18 (PA8)
/SW1: C14.2, D2.3 (K), L1.1, Q1.1 (S), Q1.2 (S), Q1.3 (S), Q2.5 (D), R76.1, U1.25 (SW1)
/SW2: C15.2, D3.1 (A), D3.2 (A), L1.2, Q3.1 (S), Q3.2 (S), Q3.3 (S), Q4.5 (D), R75.1, U1.15 (SW2)
/SWCLK: R52.1, U7.24 (PA14)
/SWDIO: R51.1, U7.23 (PA13)
/USB_D+: R48.2, U7.22 (PA12)
/USB_D-: R47.2, U7.21 (PA11)
/VIN_ADC: C70.1, D12.2 (A), D15.1 (K), R40.2, R41.1, U7.13 (PB0)
/nRST: C73.1, R39.2, R53.1, SW1.2, U7.4 (PG10)
GND: C1.2, C2.2, C4.2, C5.2, C6.2, C7.2, C8.2, C9.2, C10.2, C11.2, C12.2, C13.2, C16.2, C17.2, C18.2, C19.2, C20.2, C21.2, C22.2, C23.2, C24.2, C25.2, C26.2, C27.2, C28.2, C29.2, C30.2, C31.2, C32.2, C33.2, C34.2, C35.2, C36.2, C37.2, C38.2, C39.2, C40.2, C41.2, C42.2, C43.2, C44.2, C45.2, C46.2, C47.2, C48.2, C49.2, C50.2, C51.2, C52.2, C53.2, C54.2, C55.2, C56.2, C57.2, C58.2, C60.2, C61.2, C64.1, C65.1, C66.2, C67.2, C68.2, C69.2, C70.2, C71.2, C72.2, C73.2, C74.2, C75.2, C76.2, C77.2, C78.2, C79.2, C80.2, C81.2, C82.2, C83.2, C84.2, D1.2 (A2), D9.2 (A), D11.2 (A2), D15.2 (A), H1.1 (1_1), H2.1 (1_1), H3.1 (1_1), H4.1 (1_1), J1.3, J1.4, J1.5, J2.A1 (GND), J2.A12 (GND), J2.B1 (GND), J2.B12 (GND), J2.SH (SHIELD), J3.5, J3.6, J6.1, J7.1, J8.4, J8.6, J9.4, J9.6, NT1.2, NT2.2, Q5.2 (S), Q6.2 (S), Q7.2 (S), Q11.2 (S), Q12.2 (S), Q13.2 (S), R2.2, R3.2, R4.2, R8.2, R12.2, R13.2, R16.2, R17.2, R18.2, R23.2, R24.2, R25.2, R26.2, R27.2, R28.2, R29.2, R31.2, R33.2, R34.2, R35.2, R37.2, R41.2, R49.1, R50.1, R54.2, R56.2, R62.2, R65.2, R67.2, R69.2, R70.2, SW1.1, U1.7 (AGND), U1.19 (PGND), U1.29 (PowerPAD), U2.6 (AGND), U2.14 (PGND), U2.21 (EXP), U3.4 (GND), U3.5 (GND), U3.12 (LDSTRT), U3.14 (GND), U3.26 (PAD_GND), U4.4 (GND), U4.5 (GND), U4.12 (LDSTRT), U4.14 (GND), U4.26 (PAD_GND), U5.4 (GND), U5.5 (GND), U5.12 (LDSTRT), U5.14 (GND), U5.26 (PAD_GND), U6.4 (GND), U6.5 (GND), U6.12 (LDSTRT), U6.14 (GND), U6.26 (PAD_GND), U7.14 (VSSA), U7.16 (VSS), U7.20 (PA10), U7.32 (VSS), U8.2 (GND), U10.2 (GND), Y1.2 (G), Y1.4 (G)
unnamed: C4.1, R6.2
unnamed: C62.1, R38.2
unnamed: C83.1, R75.2
unnamed: C84.1, R76.2
unnamed: C59.1, D8.1 (K), U2.18 (HB)
unnamed: D9.1 (K), Q5.1 (G), Q6.3 (D), R15.2
unnamed: D10.1 (K), R1.1
unnamed: C79.1, D14.3, D16.1 (K), U10.1 (IN), U10.3 (EN)
unnamed: J2.A5 (CC1), R49.2
unnamed: J2.B5 (CC2), R50.2
unnamed: J2.A6 (D+), J2.B6 (D+), U8.3 (I/O2)
unnamed: J2.A7 (D-), J2.B7 (D-), U8.1 (I/O1)
unnamed: J3.2, R51.2
unnamed: J3.3, R53.2
unnamed: J3.4, R52.2
unnamed: J6.4, Q7.3 (D)
unnamed: J7.4, Q11.3 (D)
unnamed: Q1.4 (G), R74.2
unnamed: Q2.4 (G), R73.2
unnamed: Q3.4 (G), R71.2
unnamed: Q4.4 (G), R72.2
unnamed: Q5.3 (D), R7.2, R8.1, U1.26 (EN/UVLO)
unnamed: Q6.1 (G), R13.1, R14.2
unnamed: Q7.1 (G), R56.1, R60.1
unnamed: Q8.4 (G), U2.19 (HO)
unnamed: C59.2, L2.1, Q8.1 (S), Q8.2 (S), Q8.3 (S), Q9.5 (D), U2.20 (SW)
unnamed: Q9.4 (G), U2.15 (LO)
unnamed: Q11.1 (G), R61.1, R62.1
unnamed: D13.2, Q12.3 (D), R21.1
unnamed: Q12.1 (G), R66.1, R67.1
unnamed: D13.1, Q13.3 (D), R20.1
unnamed: Q13.1 (G), R68.1, R69.1
unnamed: R47.1, U8.6 (I/O1)
unnamed: R48.1, U8.4 (I/O2)
unnamed: C3.1, R10.1, U1.13 (CS)
unnamed: C3.2, R9.1, U1.12 (CSG)
unnamed: C1.1, R1.2, U1.27 (VIN)
unnamed: C62.2, C63.1, U2.9 (COMP)
unnamed: Q9.1 (S), Q9.2 (S), Q9.3 (S), R35.1, U2.12 (CS)
unnamed: NT1.1, U2.13 (CSG)
unnamed: R34.1, U2.11 (DEMB)
unnamed: R32.2, U2.4 (EN)
unnamed: C63.2, R36.2, R37.1, R38.1, U2.8 (FB)
unnamed: C50.1, U2.5 (RAMP)
unnamed: R33.1, U2.3 (RT/SYNC)
unnamed: C51.1, U2.7 (SS)
unnamed: C49.1, R30.2, R31.1, U2.2 (UVLO)
unnamed: R26.1, U3.8 (ILIM)
unnamed: R28.1, R63.1, U3.9 (IMON)
unnamed: C37.1, U3.7 (ITIMER)
unnamed: C43.1, U3.11 (NRETRY)
unnamed: C41.1, U3.10 (RETRY_DLY)
unnamed: C45.1, U3.15 (dVdt)
unnamed: R16.1, U4.8 (ILIM)
unnamed: R17.1, R57.1, U4.9 (IMON)
unnamed: C26.1, U4.7 (ITIMER)
unnamed: C25.1, U4.11 (NRETRY)
unnamed: C24.1, U4.10 (RETRY_DLY)
unnamed: C23.1, U4.15 (dVdt)
unnamed: R24.1, U5.8 (ILIM)
unnamed: R25.1, R64.1, U5.9 (IMON)
unnamed: C31.1, U5.7 (ITIMER)
unnamed: C34.1, U5.11 (NRETRY)
unnamed: C33.1, U5.10 (RETRY_DLY)
unnamed: C35.1, U5.15 (dVdt)
unnamed: R27.1, U6.8 (ILIM)
unnamed: R29.1, R55.1, U6.9 (IMON)
unnamed: C38.1, U6.7 (ITIMER)
unnamed: C44.1, U6.11 (NRETRY)
unnamed: C42.1, U6.10 (RETRY_DLY)
unnamed: C46.1, U6.15 (dVdt)
unnamed: R65.1, U7.31 (PB8)
unnamed: C64.2, U7.2 (PF0), Y1.3
unnamed: C65.2, U7.3 (PF1), Y1.1
unnamed: R54.1, U9.1 (SET)
VIN: F1.1, J1.1, J1.2
VIN_F: C16.1, C17.1, C18.1, C19.1, C20.1, C21.1, C22.1, C61.1, C71.1, D1.1 (A1), D10.2 (A), F1.2, Q1.5 (D), R7.1, R15.1, R40.1, U1.28 (VISNS), U9.3 (IN)

Notes on the sheet:
~3A nominal fast trip limit
91.7ms retry delay, 4 retries
Corsair Type 5 Cable

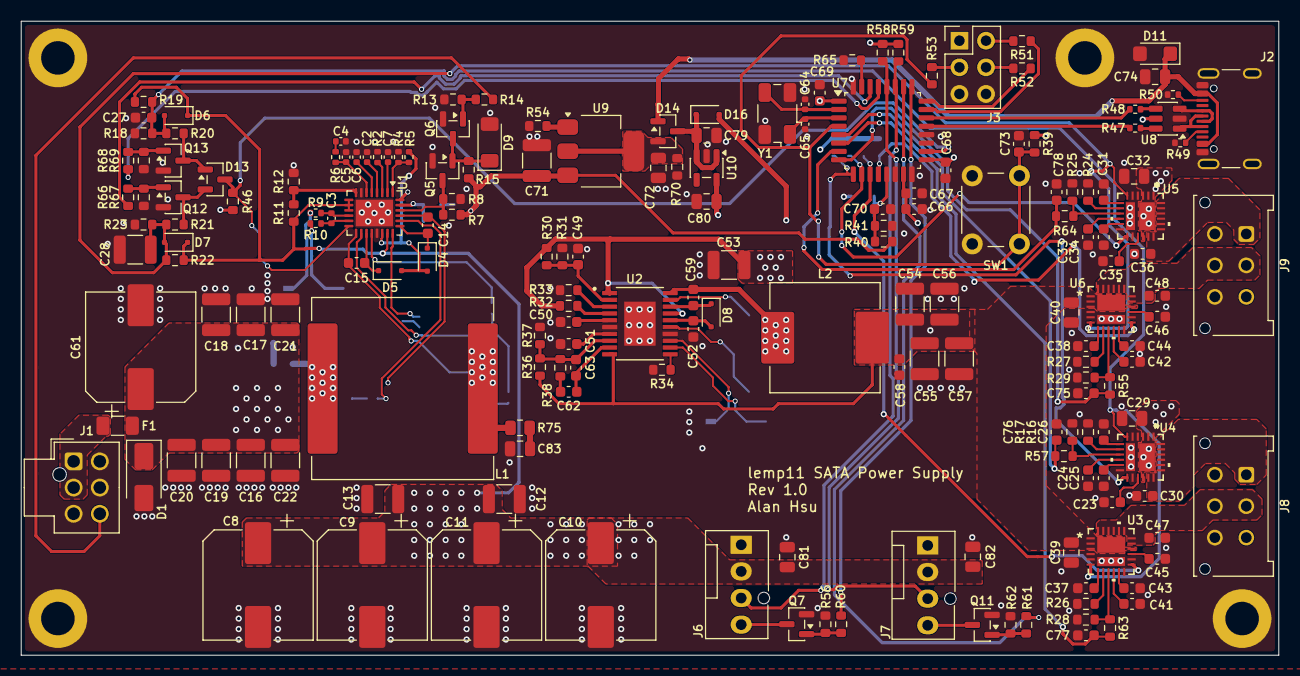
[picture p20: board SATA_board.kicad_pcb from above]

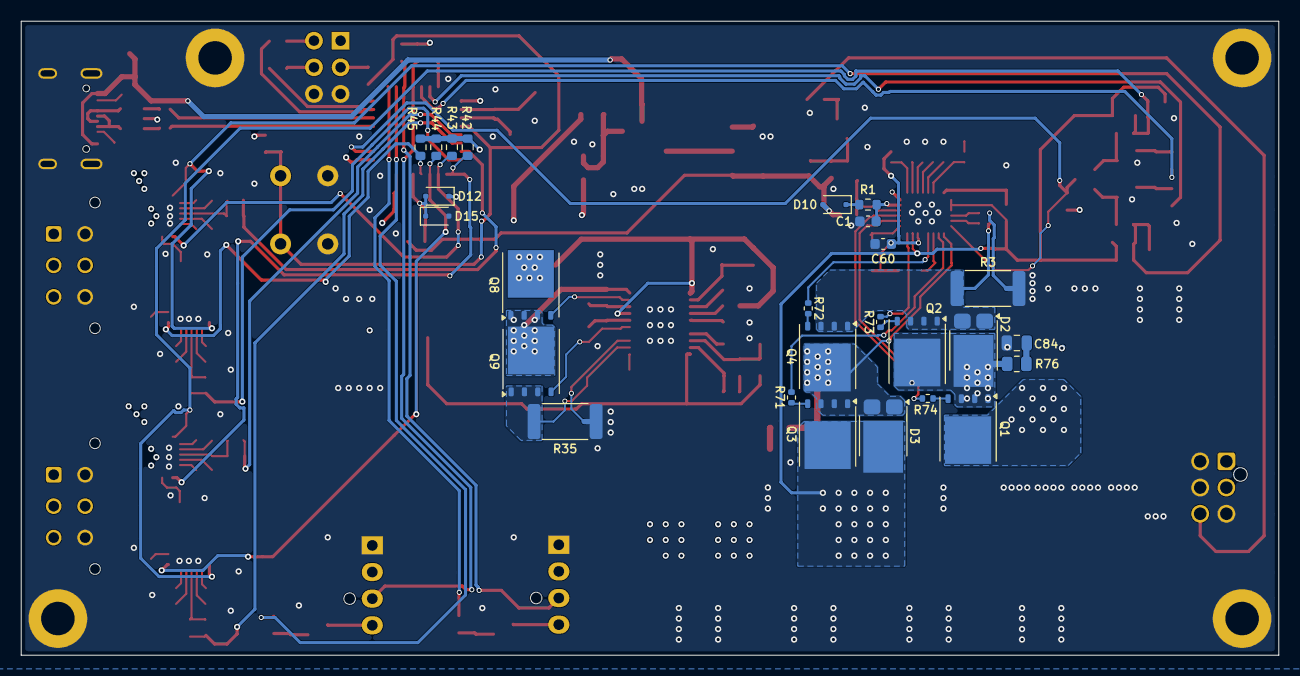
[picture p21: board SATA_board.kicad_pcb from below]

Board: 4 copper layers, 120.0 x 60.5 mm, 216 parts (28 on the bottom side), 130 nets.
