Alan-JH/lemp11-nas/firmware/firmware.ioc

Mcu.UserName=STM32G431KBTx
PA0.Signal=ADC1_IN1
PA1.Signal=ADC1_IN2
PA11.Signal=USB_DM
PA12.Signal=USB_DP
PA13.Signal=SYS_JTMS-SWDIO
PA14.Signal=SYS_JTCK-SWCLK
PA15.Signal=S_TIM2_CH1
PA2.Signal=ADC1_IN3
PA3.Signal=ADC1_IN4
PA4.Signal=GPIO_Input
PA5.Signal=GPIO_Input
PA6.Signal=GPIO_Input
PA7.Signal=GPIO_Input
PA8.Signal=GPIO_Input
PB0.Signal=ADC1_IN15
PB3.Signal=S_TIM2_CH2
PB4.Signal=GPXTI4
PB5.Signal=GPXTI5
PB6.Signal=GPIO_Output
PB7.Signal=GPIO_Output
PF0-OSC_IN.Signal=RCC_OSC_IN
PF1-OSC_OUT.Signal=RCC_OSC_OUT
