Alan-JH/lemp11-nas/(commit log)

2026-10-16 fix symbol
    [SATA_board.kicad_sch]
2026-10-22 continued schematic work
    [LM5116_quickstart.xls, LM5175 Buck-Boost Quickstart Tool -- r9.xlsm, SATA_board.kicad_sch]
2026-10-23 release the plate
    [lemp11-mountingplate.DXF, lemp11-mountingplate.SLDPRT]
2026-10-23 complete schematic, but it looks absolutely awful
    [SATA_board.kicad_pcb, SATA_board.kicad_sch]
2026-10-25 Rev 1.0 soft release (schematic is absolute dogshit)
    [SATA_board.kicad_pcb, SATA_board.kicad_sch]
2026-10-27 case cad progress
    [93655A229_Male-Female Threaded Hex Standoff.SLDPRT, 94868A012_Female Threaded Hex Standoff.SLDPRT, Assembly.SLDASM, EL90126--STD--HDD SATA 3.5.SLDPRT, EL90126--STD--HDD SATA 3.5.STEP, F9.SLDASM, F9.STEP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]
2026-10-28 case finished
    [1053101206.stp, 430450612.stp, 92080A415_Zinc-Plated Brass Female Threaded Hex Standoff.SLDPRT, 93655A100_Male-Female Threaded Hex Standoff.SLDPRT, Assembly.SLDASM, Boardmount.SLDPRT, Boardmount.STEP, CFP15_SOT1289_NEX.step]
2026-10-31 v1 export
    [Assembly.SLDASM, Boardmount.STEP, bottomcase.STEP, lemp11-mountingplate.DXF, lemp11-mountingplate.SLDPRT, lemp11-mountingplate.STEP, topcase.STEP]
2026-10-31 reduce top case thickness to 1/8 inch
    [Assembly.SLDASM, topcase.SLDPRT, topcase.STEP]
